Lewak/OuterWildsOrrery/schematic_orrery.pdf

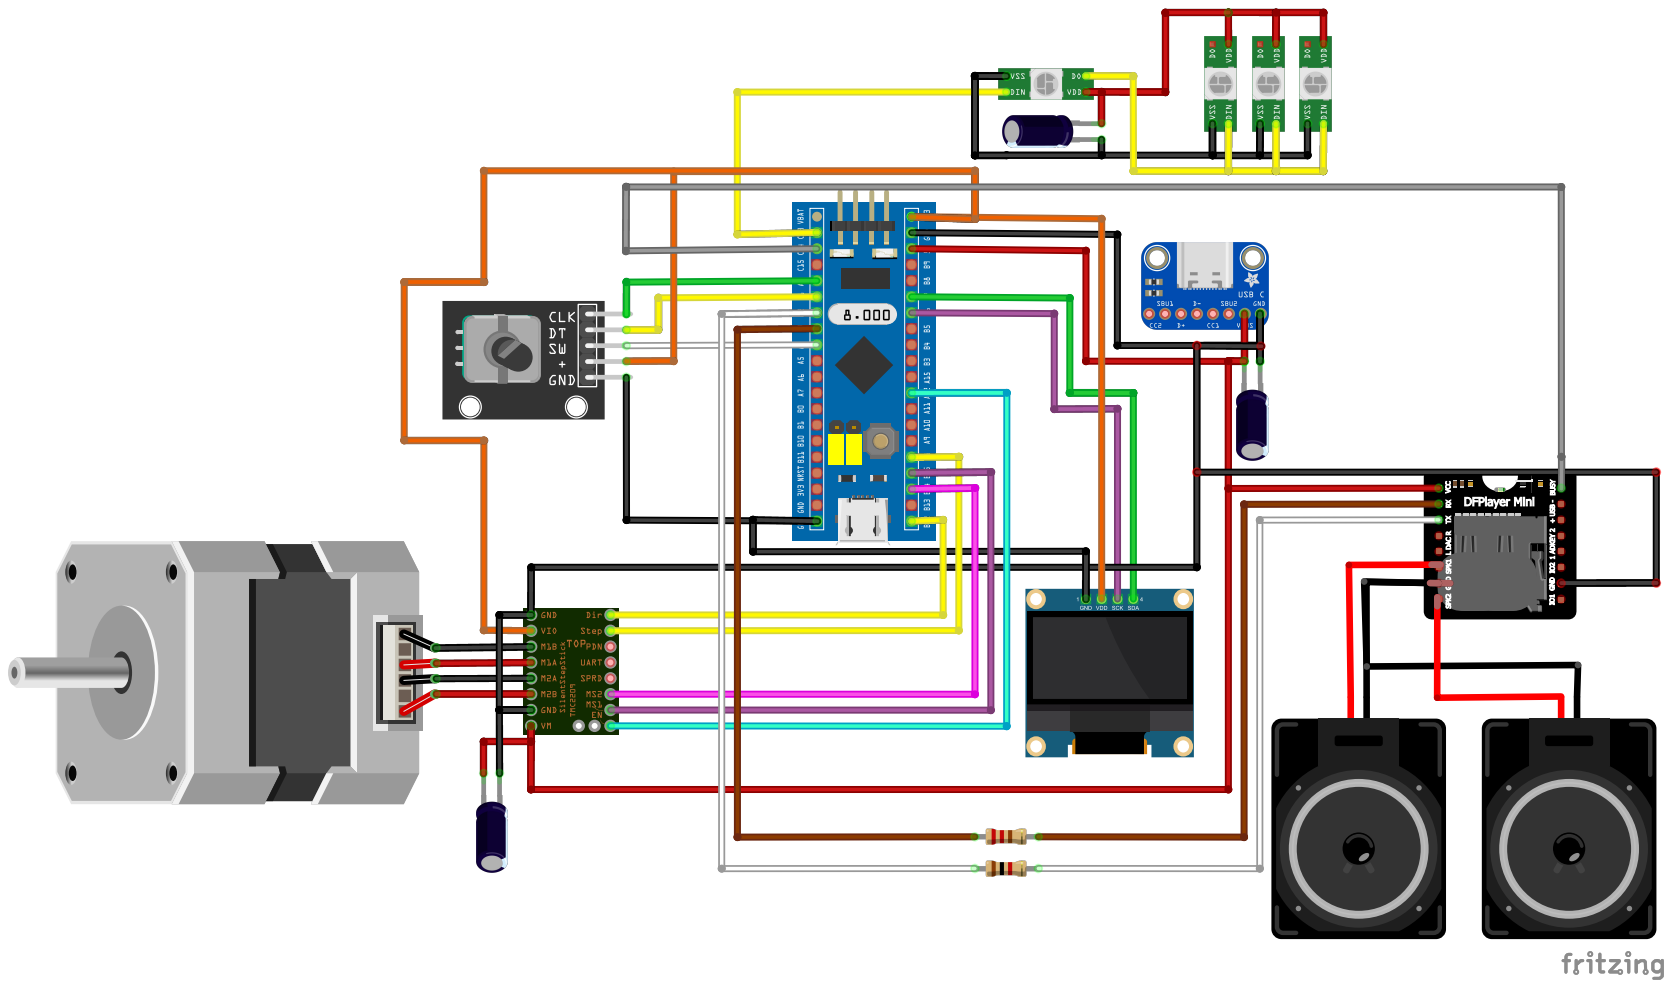
[picture p29: page 1]
