Lewak/OuterWildsOrrery/Core/Src/main.c

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
/* Includes ------------------------------------------------------------------*/
#include "main.h"
#include "dma.h"
#include "i2c.h"
#include "tim.h"
#include "usart.h"
#include "gpio.h"


void SystemClock_Config(void);
/**
  * @brief  The application entry point.
  * @retval int
  */
int main(void)
{
  /* MCU Configuration--------------------------------------------------------*/

  /* Reset of all peripherals, Initializes the Flash interface and the Systick. */
  HAL_Init();

  /* Configure the system clock */
  SystemClock_Config();

  /* Initialize all configured peripherals */
  MX_GPIO_Init();
  MX_DMA_Init();
  MX_I2C1_Init();
  MX_USART2_UART_Init();
  MX_TIM1_Init();
  MX_TIM2_Init();
  MX_TIM3_Init();
  /* USER CODE BEGIN 2 */
  HAL_TIM_Base_Start_IT(&htim3);
  HAL_TIM_Encoder_Start(&htim2, TIM_CHANNEL_ALL);
  HAL_TIM_Base_Start_IT(&htim2);

  logic();
  /* USER CODE END 2 */

  /* Infinite loop */
  /* USER CODE BEGIN WHILE */
  while (1)
  {

    /* USER CODE END WHILE */

    /* USER CODE BEGIN 3 */
  }
  /* USER CODE END 3 */
}

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
/* USER CODE BEGIN 4 */
// Callback: timer has rolled over
void HAL_TIM_PeriodElapsedCallback(TIM_HandleTypeDef *htim)
{
  // Check which version of the timer triggered this callback and toggle LED
  if (htim == &htim3 )
  {
	  handleStepsInterrupt();

	  //HAL_GPIO_TogglePin(led_GPIO_Port, led_Pin);

  }
}

/* USER CODE END 4 */
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
