Lewak/OuterWildsOrrery/Core/Inc/encoder.h

/*
 * encoder.h
 *
 *  Created on: Dec 16, 2022
 *      Author: Mazur
 */

#ifndef INC_ENCODER_H_
#define INC_ENCODER_H_

int wasEncoderMoved();
int getAbsoluteEncoderValue();
int getEncoderChange();



#endif /* INC_ENCODER_H_ */
