Lewak/OuterWildsOrrery/Core/Inc/bitmap.h

#ifndef __SSD1306_TEST_H__
#define __SSD1306_TEST_H__

#include <_ansi.h>

_BEGIN_STD_C


void drawNextBitmap();
void drawLogo();

const unsigned char eye64x64 [] = {
		0x00, 0x00, 0x00, 0x00, 0x00, 0x00, 0x00, 0x00, 0x00, 0x00, 0x00, 0x01, 0x80, 0x00, 0x00, 0x00,
		0x00, 0x00, 0x00, 0x01, 0x80, 0x00, 0x00, 0x00, 0x00, 0x00, 0x00, 0x01, 0x80, 0x00, 0x00, 0x00,
		0x00, 0x00, 0x00, 0x01, 0x80, 0x00, 0x00, 0x00, 0x00, 0x00, 0x00, 0x01, 0x80, 0x00, 0x00, 0x00,
		0x00, 0x00, 0x00, 0x01, 0x80, 0x00, 0x00, 0x00, 0x00, 0x00, 0x00, 0x01, 0x80, 0x00, 0x00, 0x00,
		0x00, 0x00, 0x00, 0x01, 0x80, 0x00, 0x00, 0xC0, 0x00, 0x00, 0x00, 0x01, 0x80, 0x00, 0x00, 0xC0,
		0x00, 0x00, 0x00, 0x0F, 0x80, 0x60, 0x03, 0x00, 0x00, 0x00, 0x00, 0x0F, 0x80, 0x60, 0x03, 0x00,
		0x01, 0x81, 0xC0, 0x0F, 0x81, 0x80, 0x0C, 0x00, 0x01, 0x81, 0xC0, 0x0F, 0x81, 0x80, 0x0C, 0x00,
		0x00, 0x60, 0x30, 0x0E, 0x06, 0x00, 0x70, 0x00, 0x00, 0x60, 0x30, 0x0E, 0x06, 0x00, 0x70, 0x00,
		0x00, 0x78, 0x3C, 0x0F, 0xC6, 0x60, 0xF0, 0x00, 0x00, 0x18, 0x0C, 0x0F, 0xE6, 0x60, 0xF0, 0x00,
		0x00, 0x06, 0x03, 0xCF, 0xF9, 0x9F, 0xC0, 0x00, 0x00, 0x07, 0x03, 0xCF, 0xF9, 0x9F, 0xC0, 0x00,
		0x00, 0x07, 0xC3, 0xFF, 0xF9, 0xFF, 0x80, 0x00, 0x00, 0x01, 0xC0, 0xF8, 0x19, 0xFF, 0x00, 0x00,
		0x00, 0x01, 0xC0, 0xF8, 0x19, 0xFF, 0x00, 0x00, 0x00, 0x00, 0x3F, 0x0F, 0xE6, 0x60, 0x00, 0x00,
		0x00, 0x00, 0x3F, 0x0F, 0xE6, 0x60, 0x00, 0x00, 0x00, 0x00, 0x0F, 0xF9, 0xE6, 0x7C, 0x00, 0x00,
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
0x00, 0x02, 0xFF, 0x8F, 0xF0, 0xFF, 0x9C, 0x00, 0x00, 0x04, 0xFF, 0xF0, 0x0F, 0xFF, 0x3C, 0x00,
0x00, 0x07, 0x7F, 0xFF, 0xFF, 0xFE, 0x7C, 0x00, 0x00, 0x07, 0xBF, 0xFF, 0xFF, 0xFD, 0xFC, 0x00,
0x00, 0x07, 0xCF, 0xFF, 0xFF, 0xF3, 0xFC, 0x00, 0x00, 0x07, 0xF3, 0xFF, 0xFF, 0xC0, 0x1C, 0x00,
0x00, 0x07, 0xF8, 0xFF, 0xFE, 0x10, 0x00, 0x00, 0x00, 0x07, 0xE1, 0x07, 0xE0, 0xF0, 0x00, 0x00,
0x00, 0x07, 0x00, 0xF0, 0x0F, 0xE0, 0x00, 0x00, 0x00, 0x00, 0x00, 0xFF, 0x0F, 0xE0, 0x00, 0x00,
0x00, 0x00, 0x00, 0x7E, 0x03, 0xE0, 0x00, 0x00, 0x00, 0x00, 0x00, 0x3C, 0x01, 0xC0, 0x00, 0x00,
0x00, 0x00, 0x00, 0x38, 0x00, 0xC0, 0x00, 0x00, 0x00, 0x00, 0x00, 0x10, 0x00, 0x00, 0x00, 0x00
};
_END_STD_C

#endif // __SSD1306_TEST_H__
