Lewak/OuterWildsOrrery/Core/Inc/logic.h

/*
 * logic.h
 *
 *  Created on: Dec 1, 2022
 *      Author: Mazur
 */

#ifndef INC_LOGIC_H_
#define INC_LOGIC_H_


#ifdef __cplusplus
extern "C"
{
#endif
void logic();

#ifdef __cplusplus
}
#endif

#endif
