Lewak/OuterWildsOrrery/Core/Inc/songs.h

/*
 * songs.h
 *
 *  Created on: Dec 12, 2022
 *      Author: Mazur
 */

#ifndef INC_SONGS_H_
#define INC_SONGS_H_

#define end_times 1
#define supernova 99
#define songCount 8


#endif /* INC_SONGS_H_ */
